oringing/ModbusRTU_Gateway/docs/协议说明.md

# Modbus RTU 协议实现说明

## 1. 协议实现范围

### 1.1 基本配置
- **工作模式**：Modbus RTU 从机
- **从机地址**：`MODBUS_SLAVE_ADDR = 0x01`
- **校验方式**：Modbus CRC-16（低字节在前，高字节在后）

### 1.2 已实现功能码
| 功能码 | 功能描述 | 状态 |
|---|---|---|
| `0x03` | 读保持寄存器 | ✅ 稳定实现 |
| `0x06` | 写单个寄存器 | ✅ 稳定实现 |

---

## 2. 帧处理流程

### 2.1 接收处理链路
```
UART_Driver_Receive() 
  → Modbus_ValidateFrame()  // 帧合法性校验
    → Modbus_Process()      // 功能码分发
      → 0x03/0x06 处理函数
```

### 2.2 帧校验规则（Modbus_ValidateFrame）
1. **最小帧长校验**：`frame_len ≥ MODBUS_MIN_FRAME_LEN (8 bytes)`（0x03/0x06 请求帧固定长度）
2. **从机地址校验**：`frame[MODBUS_RESP_ADDR_IDX] == MODBUS_SLAVE_ADDR`
3. **CRC-16 校验**：
   - **字节序**：低字节在前（`frame[len-2]`），高字节在后（`frame[len-1]`）
   - **校验范围**：除 CRC 外的所有字节（`frame[0] ~ frame[len-3]`）
   - **算法**：标准 Modbus CRC-16（多项式 `0xA001`，初始值 `0xFFFF`）

---

## 3. 功能码 `0x03` 实现规范

### 3.1 请求帧格式
| 字节偏移 | 字段 | 长度 | 宏定义 | 说明 |
|---|---|---|---|---|
| 0 | 从机地址 | 1 byte | `MODBUS_RESP_ADDR_IDX` | `0x01` |
| 1 | 功能码 | 1 byte | `MODBUS_RESP_FUNC_CODE_IDX` | `0x03` |
| 2-3 | 起始地址 | 2 bytes | `MODBUS_REQ_START_ADDR_HIGH_IDX` / `LOW_IDX` | 高字节在前（Big-Endian） |
| 4-5 | 寄存器数量 | 2 bytes | `MODBUS_REQ_REG_COUNT_HIGH_IDX` / `LOW_IDX` | 高字节在前 |
| 6-7 | CRC-16 | 2 bytes | - | **低字节在前，高字节在后** |

**示例帧**：`01 03 00 00 00 05 [CRC_L] [CRC_H]`
- 读取从地址 0 开始的 5 个寄存器

### 3.2 响应帧格式
| 字节偏移 | 字段 | 长度 | 宏定义 | 说明 |
|---|---|---|---|---|
| 0 | 从机地址 | 1 byte | `MODBUS_RESP_ADDR_IDX` | `0x01` |
| 1 | 功能码 | 1 byte | `MODBUS_RESP_FUNC_CODE_IDX` | `0x03` |
| 2 | 字节计数 | 1 byte | `MODBUS_RESP_BYTE_COUNT_IDX` | `寄存器数量 × 2` |
| 3~N | 寄存器数据 | N bytes | `MODBUS_RESP_DATA_START_IDX` + offset | 每个寄存器 2 bytes（高字节在前） |
| N+1~N+2 | CRC-16 | 2 bytes | - | **低字节在前，高字节在后** |

**示例响应**：`01 03 0A [Reg0_H] [Reg0_L] ... [Reg4_H] [Reg4_L] [CRC_L] [CRC_H]`

### 3.3 入参校验规则
| 校验项 | 规则 | 异常码 |
|---|---|---|
| 起始地址 | `start_addr < MODBUS_REG_MAX_COUNT` | `0x02`（非法数据地址） |
| 寄存器数量 | `reg_count ≥ 1 && reg_count ≤ MODBUS_MAX_READ_REGS (10)` | `0x03`（非法数据值） |
| 地址+数量边界 | `start_addr + reg_count ≤ MODBUS_REG_MAX_COUNT` | `0x02` |

---

## 4. 功能码 `0x06` 实现规范

### 4.1 请求帧格式
| 字节偏移 | 字段 | 长度 | 宏定义 | 说明 |
|---|---|---|---|---|
| 0 | 从机地址 | 1 byte | `MODBUS_RESP_ADDR_IDX` | `0x01` |
| 1 | 功能码 | 1 byte | `MODBUS_RESP_FUNC_CODE_IDX` | `0x06` |
| 2-3 | 寄存器地址 | 2 bytes | `MODBUS_REQ_REG_ADDR_HIGH_IDX` / `LOW_IDX` | 高字节在前 |
| 4-5 | 寄存器值 | 2 bytes | `MODBUS_REQ_REG_VALUE_HIGH_IDX` / `LOW_IDX` | 高字节在前 |
| 6-7 | CRC-16 | 2 bytes | - | **低字节在前，高字节在后** |

**示例帧**：`01 06 00 04 00 5A [CRC_L] [CRC_H]`
- 将地址 0x0004 的寄存器写入值 0x005A（十进制 90）

### 4.2 成功响应
- **响应内容**：原样回显请求帧（8 bytes）
- **响应时机**：寄存器值写入成功后立即回显

### 4.3 入参校验规则
| 校验项 | 规则 | 异常码 |
|---|---|---|
| 寄存器地址 | `addr < MODBUS_REG_MAX_COUNT` 且 `holding_regs[addr].read_only == false` | `0x02` / `0x03` |
| 写入值范围（仅舵机寄存器） | `0x0004: 0 ~ 180`（舵机角度）<br>`0x0005: 0 ~ 255`（舵机速度） | `0x03` |
| 其他寄存器 | 预留寄存器（0x0006-0x0009）无值范围限制，写入后原样回显 | - |

**说明**：
- 当前版本仅对舵机相关寄存器（0x0004/0x0005）实施严格的值范围校验
- 预留寄存器（0x0006-0x0009）允许写入任意合法16位值，但不影响系统功能
- 只读寄存器（0x0000-0x0003）禁止写入，返回异常码 0x03

---

## 5. 异常响应规范

### 5.1 异常帧格式
| 字节偏移 | 字段 | 长度 | 宏定义 | 说明 |
|---|---|---|---|---|
| 0 | 从机地址 | 1 byte | `MODBUS_EX_RESP_ADDR_IDX` | `0x01` |
| 1 | 异常功能码 | 1 byte | `MODBUS_EX_RESP_FUNC_CODE_IDX` | `原功能码 | 0x80` |
| 2 | 异常码 | 1 byte | `MODBUS_EX_RESP_EX_CODE_IDX` | 见下表 |
| 3-4 | CRC-16 | 2 bytes | - | **低字节在前，高字节在后** |

### 5.2 异常码定义
| 异常码 | 含义 | 触发条件 |
|---|---|---|
| `0x01` | 非法功能码 | 请求功能码非 0x03/0x06 |
| `0x02` | 非法数据地址 | 寄存器地址越界或不允许写入 |
| `0x03` | 非法数据值 | 寄存器数量非法或写入值超限 |

### 5.3 静默丢弃场景（不响应）
- CRC 校验失败
- 从机地址不匹配
- 帧长度不符合最小要求（< `MODBUS_MIN_FRAME_LEN`）

---

## 6. 寄存器映射表

**详细说明**：完整的寄存器地址表、默认值设计、死区保护机制请参见 [寄存器映射表.md](寄存器映射表.md)

### 6.1 寄存器访问策略
- **读操作（0x03）**：单次加锁快照读取，避免并发不一致
- **写操作（0x06）**：锁内更新值，锁外执行回调（避免死锁）
- **互斥保护**：所有寄存器访问通过 `s_modbus_reg_mutex` 互斥锁保护

## 7. AHT20与BMP280传感器数据更新机制

### 7.1 数据流转链路
```C
Device_Task (1000ms 周期) → EnvSensor_Driver_ReadData() // 读取 AHT20/BMP280 原始数据 → 数据转换（float → Modbus 寄存器格式） → Modbus_InternalWriteRegister() // 更新寄存器 0x0000-0x0002 → 状态寄存器更新（0x0003 Bit4-5）
```

### 7.2 数据转换规则
| 传感器数据 | 转换公式 | 寄存器地址 | 存储格式 |
|---|---|---|---|
| 温度（°C） | `reg = (int16_t)(temp × 10.0 + 0.5) + 1000` | 0x0000 | 有符号 16 位（偏移量 1000 支持零下温度），+0.5实现四舍五入 |
| 湿度（%RH） | `reg = (uint16_t)(humi × 10.0 + 0.5)` | 0x0001 | 无符号 16 位（保留 1 位小数） |
| 气压（hPa） | `reg = (uint16_t)(press × 10.0 + 0.5)` | 0x0002 | 无符号 16 位（保留 1 位小数） |

**示例**：
- 温度 25.6°C → `(25.6 × 10 + 0.5) + 1000 = 1256` → `0x04E8`
- 湿度 68.9% → `68.9 × 10 + 0.5 = 689` → `0x02B1`
- 气压 996.5 hPa → `996.5 × 10 + 0.5 = 9965` → `0x26ED`

### 7.3 故障处理策略
1. **重试机制**：单个传感器读取失败时重试 2 次（间隔 10ms）
2. **连续失败阈值**：连续失败 5 次后标记传感器故障（更新 0x0003 Bit4-5）
3. **总线恢复**：达到失败阈值后自动调用 `I2C_Bus_Recover()` 并重新初始化传感器
4. **数据保持**：读取失败时返回上次有效值，避免寄存器跳变
5. **温差校验**：AHT20 与 BMP280 温度差值超过 ±5°C 时丢弃 BMP280 数据

### 7.4 状态寄存器联动
- **Bit4（AHT20_READY）**：由 `EnvSensor_Driver_GetStatus()` 返回的 Bit4 同步更新
- **Bit5（BMP280_READY）**：由 `EnvSensor_Driver_GetStatus()` 返回的 Bit5 同步更新
- **更新时机**：每次传感器读取完成后立即更新，无论成功或失败
