oringing/ModbusRTU_Gateway/docs/寄存器映射表.md

# 寄存器映射表

>**最后更新**: 2026-05-20  
> 本文档提供 Modbus RTU 从机的完整寄存器映射、位定义及控制说明，适用于二次开发。  
> **宏定义位置**：[`App/Protocol/Inc/modbus.h`](../App/Protocol/Inc/modbus.h)  
> **协议层实现细节**：参见 [协议说明.md](协议说明.md)

## 📋 保持寄存器地址表（10 个）

**宏定义文件**：[`modbus.h:74-81`](../App/Protocol/Inc/modbus.h#L74-L81)

| 地址 | 宏定义 | 功能说明 | 读写 | 范围 | 联动功能 |
|---|---|---|---|---|---|
| 0x0000 | [MODBUS_REG_ADDR_SENSOR_TEMP](file://d:\STM32\myproject\ModbusRTU_Gateway\App\Protocol\Inc\modbus.h#L75-L76) | **AHT20 温度** | 只读 | 0x0258~0x073A（600~1850对应 -40.0~85.0°C） | 十进制实际值 = (存储值 - 1000) / 10 |
| 0x0001 | [MODBUS_REG_ADDR_SENSOR_HUMIDITY](file://d:\STM32\myproject\ModbusRTU_Gateway\App\Protocol\Inc\modbus.h#L76-L77) | **AHT20 湿度** | 只读 | 0x0000～0x03E8 （0~1000对应 0.0~100.0%RH） | 十进制实际值 = 存储值 / 10 |
| 0x0002 | [MODBUS_REG_ADDR_SENSOR_PRESSURE](file://d:\STM32\myproject\ModbusRTU_Gateway\App\Protocol\Inc\modbus.h#L77-L78) | **BMP280 气压** | 只读 | 0x0BB8~0x2AF8（3000~11000对应 300.0~1100.0 hPa） | 十进制实际值 = 存储值 / 10 |
| 0x0003 | [MODBUS_REG_ADDR_DEVICE_STATUS](file://d:\STM32\myproject\ModbusRTU_Gateway\App\Protocol\Inc\modbus.h#L78-L79) | **系统状态寄存器** | 只读 | 位定义见下 | 心跳+故障标志 |
| 0x0004 | [MODBUS_REG_ADDR_SERVO_TARGET](file://d:\STM32\myproject\ModbusRTU_Gateway\App\Protocol\Inc\modbus.h#L79-L80) | **180° 舵机目标角度** | 读写 | 0~180 | TIM3_CH1/PA6 |
| 0x0005 | [MODBUS_REG_ADDR_SERVO_SPEED](file://d:\STM32\myproject\ModbusRTU_Gateway\App\Protocol\Inc\modbus.h#L80-L81) | **360° 舵机速度/方向** | 读写 | 0~255 | TIM3_CH2/PA7 |
| 0x0006~0x0009 | - | 预留扩展 | 读写 | 0x0000 | 未来功能扩展 |
---

## ⚙️ 寄存器默认初始值

**代码位置**：[`modbus.c:25-26`](../App/Protocol/Src/modbus.c#L25-L26)

``` c
//（舵机寄存器默认值超出合法范围, 强制主机首次写入合法角度后舵机才能使用）

static const uint16_t s_default_regs[] = {
    0x0000U,  // 对应地址 0x0000: AHT20 温度（预留）
    0x1000U,  // 对应地址 0x0001: AHT20 湿度（预留）
    0x2000U,  // 对应地址 0x0002: BMP280 气压（预留）
    0x3000U,  // 对应地址 0x0003: 系统状态寄存器（心跳+标志位）
    0x4000U,   // 对应地址 0x0004: 180° 舵机目标角度
    0x5000U   // 对应地址 0x0005: 360° 舵机速度/方向
};
//剩余地址0x0007-0x0009寄存器值默认为0x0000
```

### 默认值设计说明

| 寄存器地址 | 默认值（十六进制） | 默认值（十进制） | 设计意图 |
|---|---|---|---|
| 0x0000 | `0x0000` | 0 | 传感器未初始化时返回零值，便于主机判断设备状态 |
| 0x0001 | `0x1000` | 4096 | 占位符，区分于温度寄存器（0x0000），避免误判 |
| 0x0002 | `0x2000` | 8192 | 占位符，区分于温湿度寄存器，便于调试识别 |
| 0x0003 | `0x3000` | 12288 | Bit 8-15 = 0x30（系统标识），Bit 0-7 = 0x00（初始心跳位） |
| 0x0004 | `0x4000` | 16384 | **故意设置为非法值**，强制主机首次写入合法角度（0-180）后才可使用舵机 |
| 0x0005 | `0x5000` | 0 | 360° 舵机默认反转最快，需主机显式写入中位（0x7F）停止 |

**⚠️ 重要提示**：
- **不要随意修改默认值**：这些值经过精心设计，用于区分不同寄存器类型和强制主机初始化
- **地址 0x0004 的非法默认值**：确保舵机在上电后不会意外转动，必须由主机显式写入合法角度
- **传感器占位符**：0x0000~0x2000 为初始化占位符，Device_Task 启动后会被真实传感器数据覆盖

---

## 🔍 寄存器详细说明

### 0x0000~0x0002 - 传感器数据（已接入）

**读写权限**：只读（R）  
**当前状态**：**已由 Device_Task 每 1 秒自动更新真实传感器数据**  
**数据来源**：AHT20（温湿度）+ BMP280（气压/温度）  
**更新机制**：详见 [协议说明.md - 传感器数据更新机制](协议说明.md#7-传感器数据更新机制)

| 地址 | 传感器类型 | 数据格式 | 说明 |
|---|---|---|---|
| 0x0000 | AHT20 温度 | 有符号 16 位（×10 + 1000偏移） | 单位 0.1℃，存储值 = (温度 × 10) + 1000（添加偏移量支持零下温度），范围 -400~1850 |
| 0x0001 | AHT20 湿度 | 无符号 16 位（×10） | 单位 0.1% RH，范围 0~1000 |
| 0x0002 | BMP280 气压 | 无符号 16 位（×10） | 单位 0.1 hPa，范围 3000~11000 |

**读取示例**（假设温度 25.6℃，湿度 68.9%，气压 996.5 hPa）：

| 寄存器 | 实际值 | 计算公式 | 存储值 | 十六进制 |
|---|---|---|---|---|
| 0x0000 | 25.6℃ | (25.6 × 10) + 1000 = 1256 | 1256 | 0x04E8 |
| 0x0001 | 68.9% | 68.9 × 10 = 689 | 689 | 0x02B1 |
| 0x0002 | 996.5 hPa | 996.5 × 10 = 9965 | 9965 | 0x26ED |

发送指令：`01 03 00 00 00 03 05 CB`
预期响应：`01 03 06 04 E8 02 B1 26 ED XX XX`

**故障场景**：
- 传感器未接入或初始化失败：默认值不变（0x0000/0x1000/0x2000）
- 传感器初始化后突发故障：返回上次有效值（保持寄存器不变）
- 状态寄存器 Bit4/Bit5 可用于判断传感器健康状态

### 0x0003 - 系统状态寄存器

**读写权限**：只读（R）  
**初始值**：`0x3000`（上电复位后）  
**更新频率**：每秒自动更新（心跳 Bit 0~3）

#### 位定义

| Bit 位 | 名称 | 含义 | 默认值 | 说明 |
|---|---|---|---|---|
| 0~3 | `HEARTBEAT_COUNTER` | 心跳计数器 | 动态翻转 | 0x0000 ↔ 0x000F，每秒翻转一次 |
| 4 | `AHT20_READY` | AHT20 传感器状态 | 0 | 0=故障/未接入，1=正常 |
| 5 | `BMP280_READY` | BMP280 传感器状态 | 0 | 0=故障/未接入，1=正常 |
| 6 | `SERVO_DRIVER_READY` | 舵机驱动就绪标志 | 1 | 0=故障/未接入，1=正常 |
| 7 | `UART_COMM_NORMAL` | UART 通信正常标志 | 1 | 0=故障/未接入，1=正常 |
| 8-11 | 预留 |  |  |  |
| 12~15 | `RESERVED` | 保留 | 0x30 | 固定为 0x30（系统标识） |

#### 心跳运行机制（假设AHT20与BMP280传感器正常）

- **初始值**: `0x3000`（Bit 4-7 = 0x3，Bit 0-3 = 0x0）
- **翻转逻辑**: 每秒执行 `current_val ^ 0x000F`
  - 第 0 秒：`0x3030`（心跳位 0x0000）
  - 第 1 秒：`0x303F`（心跳位 0x000F）
  - 第 2 秒：`0x3030`（心跳位恢复 0x0000）
  - 循环往复：`0x3030 ↔ 0x300F`

#### 读取示例

**发送指令**：`01 03 00 03 00 01 74 0A`

**预期响应**：`01 03 02 30 30 AC 44` 或 `01 03 02 30 3F EC 40`

**验证方法**：
连续读取该寄存器，观察高字节的变化：
```
首次读取: 01 03 02 30 30 AC 44  （0x3000）
1s后: 01 03 02 30 3F EC 40  （0x300F）
2s后: 01 03 02 30 30 AC 44  （0x3000）
...
```

---

### 0x0004 - 180° 舵机目标角度

**读写权限**：可写（W）  
**控制方式**：Modbus 写单寄存器（0x06）

#### 参数映射

| 写入值（十六进制） | 对应角度 | PWM 脉宽 | 占空比 |
|---|---|---|---|
| 0x00 | 0° | 0.5ms |  2.5% |
| 0x5A |  90° | 1.5ms |  7.5% |
| 0xB4 | 180° | 2.5ms | 12.5% |

#### 计算公式

```c
// 角度 → PWM 脉宽（微秒）
pulse_width_us = 500 + (angle * 2000 / 180);

// PWM 脉宽 → 占空比（50Hz，周期 20ms）
duty_cycle = pulse_width_us / 20000.0;
```

#### 写入示例

**发送指令**：`01 06 00 04 00 5A 48 30`（写入 90°）

**预期响应**：`01 06 00 04 00 5A 48 30`（原样回显）

**验证方法**：
1. 发送写入指令
2. 观察舵机是否转到 90°
3. 发送读取指令 `01 03 00 04 00 01 C5 CB` 确认返回值

**读取确认响应**：`01 03 02 00 5A 38 7F`

#### 错误处理

| 错误场景 | 返回异常帧 | 异常码 |
|---|---|---|
| 写入值 > 0xB4 | `01 86 03 02 61 ` | 0x03（非法数据值） |
| 写入值 < 0x00 | `01 86 03 02 61 ` | 0x03（非法数据值） |

---

### 0x0005 - 360° 舵机速度/方向

**读写权限**：可写（W）  
**控制方式**：Modbus 写单寄存器（0x06）

#### 参数映射

| 写入值 | 运动状态 | PWM 脉宽 | 占空比 | 说明 |
|---|---|---|---|---|
| 0x00~0x74 | 反转调速 | 2.5~1.60ms | 12.5~8.0% | 值越小反转越快 |
| **0x75** | **慢速反转** | **1.58ms** | **7.9%** | **反转有效下界（稳定转动）** |
| **0x76~0x88** | **死区保护** | **1.5ms** | **7.5%** | **固件强制归零至0x7F，舵机静止** |
| **0x89** | **慢速正转** | **1.42ms** | **7.1%** | **正转有效上界（稳定转动）** |
| 0x8A~0xFF | 正转调速 | 1.40~0.5ms | 7.0~2.5% | 值越大正转越快 |

**⚠️ 死区保护机制**：
- **自动过滤范围**：0x76-0x88（十进制118-136，共19个值）
- **保护策略**：写入此范围内的任意值，固件内部自动转换为0x7F（完全停止）
- **设计目的**：避免PWM脉宽变化过小（<80μs）导致舵机在"微动"与"静止"间随机切换，应对长时间运转后的机械磨损和温度漂移
- **有效速度边界**：
  - 反转有效范围：0x00-0x75（0x75为慢速反转边界，稳定转动）  
  - 正转有效范围：0x89-0xFF（0x89为慢速正转边界，稳定转动）

**✅ 固件已实现自动死区保护**：
- **死区范围**：0x76-0x88（±10档，对应PWM变化约±80μs）
- **保护策略**：写入此范围内的任意值，固件自动强制归零至0x7F（完全停止）
- **有效速度边界**：
  - 反转有效范围：0x00-0x75（0x75对应慢速反转，0x00对应最大速度反转）  
  - 正转有效范围：0x88-0xFF（0x88对应慢速正转，0xFF对应最大速度正转）   

**建议**：
1. **跳变策略**：如需反转→正转切换，建议直接跳变至目标速度（如0x60→0xA0），避免逐步穿越死区
2. **最小有效速度**：实际应用中建议设置最小有效速度为 0x50（反转）和 0xA0（正转），预留更大安全裕度
3. **应用层滤波**：如需更平滑控制，可在上位机实现滞回比较器或斜坡函数

#### 写入示例

**正转**：
- 发送指令：`01 06 00 05 00 FF D9 8B`（写入 255）
- 预期响应：`01 06 00 05 00 FF D9 8B`
- 观察现象：舵机正转最快

**停止**：
- 发送指令：`01 06 00 05 00 7F D8 2B`（写入 127）
- 预期响应：`01 06 00 05 00 7F D8 2B`
- 观察现象：舵机完全静止

**反转**：
- 发送指令：`01 06 00 05 00 00 99 CB`（写入 0）
- 预期响应：`01 06 00 05 00 00 99 CB`
- 观察现象：舵机反转最快

#### 错误处理

| 错误场景 | 返回异常帧 | 异常码 |
|---|---|---|
| 写入值 > 0xFF  | `01 86 03 02 61 ` | 0x03（非法数据值） |
| 写入值 < 0x00 | `01 86 03 02 61 ` | 0x03（非法数据值） |

---

## 🛠️ 常用 Modbus 指令速查

### 读保持寄存器（0x03）

**格式**：`[从机地址] [功能码] [起始地址高] [起始地址低] [数量高] [数量低] [CRC 低] [CRC 高]`

**示例**：
```
# 读地址 0x0004（180° 舵机当前角度）
01 03 00 04 00 01 C5 CB

# 读地址 0x0000~0x0002（传感器数据）
01 03 00 00 00 03 05 CB

# 读地址 0x0003（系统状态）
01 03 00 03 00 01 74 0A
```

### 写单寄存器（0x06）

**格式**：`[从机地址] [功能码] [地址高] [地址低] [值高] [值低] [CRC 低] [CRC 高]`

**示例**：
```
# 写地址 0x0004，值 90（舵机转到 90°）
01 06 00 04 00 5A 48 30

# 写地址 0x0005，值 255（360° 舵机正转最快）
01 06 00 05 00 FF D9 8B
```

### 异常响应

**格式**：`[从机地址] [功能码+0x80] [异常码] [CRC 低] [CRC 高]`

**异常码定义**：
- `0x01`：非法功能码
- `0x02`：非法数据地址
- `0x03`：非法数据值

**示例**：
```
# 越界地址访问（地址 0x0010 超出范围）
请求: 01 06 00 10 00 01 49 CF
响应: 01 86 02 C3 A1  （异常码 0x02）

# 非法值写入（值 500 超出 0~180 范围）
请求: 01 06 00 04 01 F4 C8 1C 
响应: 01 86 03 02 61   （异常码 0x03）
```

---

## 📊 寄存器访问时序图

### 正常读写流程

```
主机                          从机
 │                              │
 │发─── 01 06 00 04 00 5A ─────►│  （写 90°）
 │                              │
 │收◄─── 01 06 00 04 00 5A ─────│  （原样回显）
 │                              │
 │发─── 01 03 00 04 00 01 ─────►│  （读确认）
 │                              │
 │收◄─── 01 03 02 00 5A ────────│  （返回 90）
 │                              │
```

### 异常处理流程
- 以0x02非法数据地址为例

```
主机                          从机
 │                              │
 │发─── 01 06 00 10 00 01 ──────►│  （写越界地址）
 │                              │
 │收◄─── 01 86 02 ───────────────│  （异常码 0x02）
 │                              │
```

---

## ⚠️ 注意事项

### 1. CRC 校验
- **字节序**：低字节在前，高字节在后
- **算法**：CRC-16/MODBUS（多项式 0x8005）
- **工具推荐**：串口助手内置 ModbusCRC16 自动计算功能（务必勾选）

### 2. 响应超时
- **典型延迟**：< 1ms
- **超时阈值**：建议设置 100ms（包含网络抖动余量）

### 3. 并发访问
- 寄存器访问已加互斥锁保护
- 单次加锁快照读取，避免并发一致性风险
- 写回调锁外执行，避免阻塞主流程

### 4. 断电保存
- 当前版本不支持寄存器值断电保存
- 重启后所有可写寄存器恢复默认值

### 5. 传感器数据特性
- **更新周期**：1000 ms（由 Device_Task 控制）
- **数据精度**：温度 ±0.3°C，湿度 ±2%RH，气压 ±1 hPa
- **故障恢复**：连续失败 5 次后自动触发 I2C 总线恢复
- **温差保护**：AHT20 与 BMP280 温度差超过 ±5°C 时丢弃 BMP280 数据
- **状态监控**：通过寄存器 0x0003 的 Bit4-5 实时监控传感器健康状态

---

**返回 [README.md](../Readme.md)** | **[硬件接线指南](HARDWARE.md)** | **[测试指南](TESTING.md)**
