oringing/ModbusRTU_Gateway/MotorGateway.ioc

Mcu.UserName=STM32F103C8Tx
PA10.Signal=USART1_RX
PA9.Signal=USART1_TX
PC13-TAMPER-RTC.GPIO_Label=LED_C13
PC13-TAMPER-RTC.Signal=GPIO_Output
PD0-OSC_IN.Signal=RCC_OSC_IN
PD1-OSC_OUT.Signal=RCC_OSC_OUT
