oringing/ModbusRTU_Gateway/Bsp/Src/soft_i2c.c

// Bsp/Src/soft_i2c.c
#include "cmsis_os.h"  // 添加这个头文件
#include "soft_i2c.h"
#include "stm32f1xx_hal.h"

// 软件 I2C 位延时（约 5μs）
static void Soft_I2C_Delay(void) {
    for (volatile uint32_t i = 0; i < 8; i++) {
        __NOP();
    }
}

void delay_ms(uint32_t ms) {
    // 如果调度器已运行，使用 RTOS 延时（让出 CPU）
    if (xTaskGetSchedulerState() == taskSCHEDULER_RUNNING) {
        vTaskDelay(pdMS_TO_TICKS(ms));
    } else {
        // 调度器未启动，使用空循环
        volatile uint32_t count = ms * 12000;  // 72MHz 校准值
        while (count--) {
            __NOP();
        }
    }
}

// 全局重试间隔，默认 55ms，0 表示不重试,BSP 初始化或任务上下文可修改，ISR 中请勿修改
static unsigned short RETRY_IN_MLSEC = I2C_DEFAULT_RETRY_MS;

void Set_I2C_Retry(unsigned short ml_sec) {
    RETRY_IN_MLSEC = ml_sec;
}

unsigned short Get_I2C_Retry(void) {
    return RETRY_IN_MLSEC;
}

// 将 SDA/SCL 配置为开漏输出，总线空闲时外部 4.7kΩ 电阻上拉至高电平
void I2C_Bus_Init(void) {
    GPIO_InitTypeDef GPIO_InitStruct = {0};

    __HAL_RCC_GPIOB_CLK_ENABLE();

    GPIO_InitStruct.Pin = SOFT_I2C_SCL | SOFT_I2C_SDA;
    GPIO_InitStruct.Mode = GPIO_MODE_OUTPUT_OD;
    GPIO_InitStruct.Pull = GPIO_PULLUP;
    GPIO_InitStruct.Speed = GPIO_SPEED_FREQ_HIGH;
    HAL_GPIO_Init(SOFT_I2C_PORT, &GPIO_InitStruct);

    SOFT_I2C_SCL_1;
    SOFT_I2C_SDA_1;
    Soft_I2C_Delay();
}

// 起始条件：SCL 高电平期间 SDA 由高变低，同时检测总线忙
static uint8_t Soft_I2C_Start(void) {
    SOFT_I2C_SDA_1;
    Soft_I2C_Delay();

    SOFT_I2C_SCL_1;
    Soft_I2C_Delay();

    // 检查总线是否被其他设备占用（SDA 应为高电平）
    if (!SOFT_I2C_SDA_READ) {
        return 1; // 总线忙
    }

    SOFT_I2C_SDA_0;
    Soft_I2C_Delay();

    SOFT_I2C_SCL_0;
    Soft_I2C_Delay();

    return 0;
}

// 停止条件：SCL 高电平期间 SDA 由低变高
static void Soft_I2C_Stop(void) {
    SOFT_I2C_SDA_0;
    Soft_I2C_Delay();

    SOFT_I2C_SCL_1;
    Soft_I2C_Delay();

    SOFT_I2C_SDA_1;
    Soft_I2C_Delay();
}

// 主机发送 ACK（拉低 SDA），在多字节读取中确认继续读取下一个字节
static void Soft_I2C_SendAck(void) {
    SOFT_I2C_SDA_0;
    Soft_I2C_Delay();
    SOFT_I2C_SCL_1;
    Soft_I2C_Delay();
    SOFT_I2C_SCL_0;
    Soft_I2C_Delay();
}

// 主机发送 NACK（释放 SDA）
static void Soft_I2C_SendNack(void) {
    SOFT_I2C_SDA_1;
    Soft_I2C_Delay();
    SOFT_I2C_SCL_1;
    Soft_I2C_Delay();
    SOFT_I2C_SCL_0;
    Soft_I2C_Delay();
}

// 等待从机应答：第 9 个时钟周期检查 SDA 是否被拉低
static uint8_t Soft_I2C_WaitAck(void) {
    uint32_t start_tick = HAL_GetTick();

    SOFT_I2C_SDA_1;
    Soft_I2C_Delay();
    SOFT_I2C_SCL_1;
    Soft_I2C_Delay();

    while (SOFT_I2C_SDA_READ) {
        // 超时保护（基于系统 tick）
        if ((HAL_GetTick() - start_tick) >= I2C_WAIT_ACK_TIMEOUT_MS) {
            Soft_I2C_Stop();
            return 2; // 无应答超时
        }
    }

    SOFT_I2C_SCL_0;
    Soft_I2C_Delay();
    return 0;
}

// 发送一个字节（MSB 优先），返回从机应答状态
static uint8_t Soft_I2C_SendByte(uint8_t data) {
    uint8_t i;

    SOFT_I2C_SCL_0;
    for (i = 0; i < 8; i++) {
        if (data & 0x80) {
            SOFT_I2C_SDA_1;
        } else {
            SOFT_I2C_SDA_0;
        }
        data <<= 1;
        Soft_I2C_Delay();

        SOFT_I2C_SCL_1;
        Soft_I2C_Delay();
        SOFT_I2C_SCL_0;
        Soft_I2C_Delay();
    }
    return Soft_I2C_WaitAck();
}

// 接收一个字节，最后发送 NACK（用于读取最后一个字节）
static uint8_t Soft_I2C_ReceiveByte(void) {
    uint8_t i, data = 0;

    SOFT_I2C_SDA_1;
    SOFT_I2C_SCL_0;

    for (i = 0; i < 8; i++) {
        SOFT_I2C_SCL_1;
        Soft_I2C_Delay();
        data <<= 1;
        if (SOFT_I2C_SDA_READ) {
            data |= 0x01;
        }
        SOFT_I2C_SCL_0;
        Soft_I2C_Delay();
    }
    Soft_I2C_SendNack();
    return data;
}

// 接收一个字节并发送 ACK（用于读取非最后一个字节）
static uint8_t Soft_I2C_ReceiveByteWithAck(void) {
    uint8_t i, data = 0;

    SOFT_I2C_SDA_1;
    SOFT_I2C_SCL_0;

    for (i = 0; i < 8; i++) {
        SOFT_I2C_SCL_1;
        Soft_I2C_Delay();
        data <<= 1;
        if (SOFT_I2C_SDA_READ) {
            data |= 0x01;
        }
        SOFT_I2C_SCL_0;
        Soft_I2C_Delay();
    }
    Soft_I2C_SendAck();
    return data;
}

// ========== 寄存器式传感器接口 ==========

// 写寄存器：START + 写地址 + 寄存器地址 + 数据 + STOP
static uint8_t Soft_I2C_WriteReg(uint8_t dev_addr, uint8_t reg_addr, uint16_t len,
                                 const uint8_t* data) {
    uint8_t i, result;

    result = Soft_I2C_Start();
    if (result) {
        return result;
    }

    result = Soft_I2C_SendByte((dev_addr << 1) | 0);
    if (result) {
        Soft_I2C_Stop();
        return result;
    }

    result = Soft_I2C_SendByte(reg_addr);
    if (result) {
        Soft_I2C_Stop();
        return result;
    }

    for (i = 0; i < len; i++) {
        result = Soft_I2C_SendByte(data[i]);
        if (result) {
            Soft_I2C_Stop();
            return result;
        }
    }

    Soft_I2C_Stop();
    return 0;
}

// 读寄存器：START + 写地址 + 寄存器地址 + RESTART + 读地址 + 数据 + STOP
static uint8_t Soft_I2C_ReadReg(uint8_t dev_addr, uint8_t reg_addr, uint16_t len, uint8_t* data) {
    uint8_t result;

    result = Soft_I2C_Start();
    if (result) {
        return result;
    }

    result = Soft_I2C_SendByte((dev_addr << 1) | 0);
    if (result) {
        Soft_I2C_Stop();
        return result;
    }

    result = Soft_I2C_SendByte(reg_addr);
    if (result) {
        Soft_I2C_Stop();
        return result;
    }

    result = Soft_I2C_Start();
    if (result) {
        Soft_I2C_Stop();
        return result;
    }

    result = Soft_I2C_SendByte((dev_addr << 1) | 1);
    if (result) {
        Soft_I2C_Stop();
        return result;
    }

    while (len) {
        if (len == 1) {
            *data = Soft_I2C_ReceiveByte();
        } else {
            *data = Soft_I2C_ReceiveByteWithAck();
        }
        data++;
        len--;
    }

    Soft_I2C_Stop();
    return 0;
}

bool Sensors_I2C_WriteRegister(unsigned char slave_addr, unsigned char reg_addr, unsigned short len,
                               const unsigned char* data_ptr) {
    bool ret;
    unsigned short retry = Get_I2C_Retry();

    do {
        ret = (Soft_I2C_WriteReg(slave_addr, reg_addr, len, data_ptr) == 0);
        if (ret) {
            break;
        }
        if (retry) delay_ms(retry);
    } while (retry--);

    return ret;
}


bool Sensors_I2C_ReadRegister(unsigned char slave_addr, unsigned char reg_addr, unsigned short len,
                              unsigned char* data_ptr) {
    bool ret;
    unsigned short retry = Get_I2C_Retry();

    do {
        ret = (Soft_I2C_ReadReg(slave_addr, reg_addr, len, data_ptr) == 0);
        if (ret) {
            break;
        }
        if (retry) delay_ms(retry);
    } while (retry--);

    return ret;
}

// ========== 命令式传感器接口 ==========

// 只写命令：START + 写地址 + 命令字节 + STOP（无寄存器地址）
static uint8_t Soft_I2C_WriteCmd(uint8_t dev_addr, uint16_t len, const uint8_t* data) {
    uint8_t i, result;

    result = Soft_I2C_Start();
    if (result) {
        return result;
    }

    result = Soft_I2C_SendByte((dev_addr << 1) | 0);
    if (result) {
        Soft_I2C_Stop();
        return result;
    }

    for (i = 0; i < len; i++) {
        result = Soft_I2C_SendByte(data[i]);
        if (result) {
            Soft_I2C_Stop();
            return result;
        }
    }

    Soft_I2C_Stop();
    return 0;
}

// 写命令字节到指定从机地址
static uint8_t Soft_I2C_WriteAddrAndCmd(uint8_t dev_addr, uint8_t cmd) {
    uint8_t result;

    result = Soft_I2C_Start();
    if (result) {
        return result;
    }

    result = Soft_I2C_SendByte((dev_addr << 1) | 0);
    if (result) {
        Soft_I2C_Stop();
        return result;
    }

    result = Soft_I2C_SendByte(cmd);
    if (result) {
        Soft_I2C_Stop();
        return result;
    }

    return 0;
}

// 重启总线并读取数据：RESTART + 读地址 + 数据 + STOP
static uint8_t Soft_I2C_RestartAndRead(uint8_t dev_addr, uint16_t len, uint8_t* data) {
    uint8_t result;

    result = Soft_I2C_Start();
    if (result) {
        Soft_I2C_Stop();
        return result;
    }

    result = Soft_I2C_SendByte((dev_addr << 1) | 1);
    if (result) {
        Soft_I2C_Stop();
        return result;
    }

    while (len) {
        if (len == 1) {
            *data = Soft_I2C_ReceiveByte();
        } else {
            *data = Soft_I2C_ReceiveByteWithAck();
        }
        data++;
        len--;
    }

    Soft_I2C_Stop();
    return 0;
}

// 组合操作：写命令后立即重启读取数据（AHT20 专用流程）
static uint8_t Soft_I2C_ReadCmdData(uint8_t dev_addr, uint8_t cmd, uint16_t len, uint8_t* data) {
    uint8_t result;

    result = Soft_I2C_WriteAddrAndCmd(dev_addr, cmd);
    if (result) {
        return result;
    }

    result = Soft_I2C_RestartAndRead(dev_addr, len, data);
    return result;
}

bool Sensors_I2C_WriteCommand(unsigned char slave_addr, const unsigned char* data,
                              unsigned short len) {
    bool ret;
    unsigned short retry = Get_I2C_Retry();

    if (data == NULL || len == 0) {
        return false;
    }

    do {
        ret = (Soft_I2C_WriteCmd(slave_addr, len, data) == 0);
        if (ret) {
            break;
        }
        if (retry) delay_ms(retry);
    } while (retry--);

    return ret;
}

bool Sensors_I2C_ReadCommandData(unsigned char slave_addr, unsigned char cmd, unsigned char* data,
                                 unsigned short len) {
    bool ret;
    unsigned short retry = Get_I2C_Retry();

    do {
        ret = (Soft_I2C_ReadCmdData(slave_addr, cmd, len, data) == 0);
        if (ret) {
            break;
        }
        if (retry) delay_ms(retry);
    } while (retry--);

    return ret;
}

// I2C 总线恢复：发送 9 个时钟脉冲 + 停止条件 + 重新初始化 GPIO
void I2C_Bus_Recover(void) {
    uint8_t i;
    
    // 1. 配置 SCL 和 SDA 为推挽输出（强制控制总线）
    GPIO_InitTypeDef GPIO_InitStruct = {0};
    
    GPIO_InitStruct.Pin = SOFT_I2C_SCL | SOFT_I2C_SDA;
    GPIO_InitStruct.Mode = GPIO_MODE_OUTPUT_PP;  // 推挽输出
    GPIO_InitStruct.Pull = GPIO_NOPULL;
    GPIO_InitStruct.Speed = GPIO_SPEED_FREQ_HIGH;
    HAL_GPIO_Init(SOFT_I2C_PORT, &GPIO_InitStruct);
    
    // 2. 发送 9 个时钟脉冲，尝试释放从机
    SOFT_I2C_SDA_1;  // 释放 SDA
    for (i = 0; i < 9; i++) {
        SOFT_I2C_SCL_0;
        Soft_I2C_Delay();
        SOFT_I2C_SCL_1;
        Soft_I2C_Delay();
    }
    
    // 3. 发送停止条件
    Soft_I2C_Stop();
    
    // 4. 重新初始化为开漏输出
    I2C_Bus_Init();
    
    // 5. 等待总线稳定
    delay_ms(10);
}
