oringing/ModbusRTU_Gateway/(commit log)

2026-04-14 feat: 完成阶段一基础框架搭建，实现LED闪烁和UART通信 - 配置了FreeRTOS任务调度 - 实现了LED 500ms闪烁功能 - 实现了UART 115200bps通信 - 添加了Readme.md项目说明
2026-04-23 feat: 实现modbus - 重构项目结构，将代码按功能划分为Bsp（硬件抽象层）、App（应用逻辑层）和Core（核心启动与FreeRTOS）三层 - 成功实现Modbus RTU从机协议栈，支持`0x03`读保持寄存器，包含地址过滤、CRC16校验及基于空闲中断的帧接收机制 - 验证：通过逻辑分析仪与ttl调试器，验证了Modbus RTU通信的稳定性和数据准确性。
2026-04-25 refactor(core): 深度解耦main.c并完成App层精细化分层
    - 架构重构：按规范将App层精细划分为Driver、Protocol、System、Task四个子模块，彻底解决业务代码散乱问题
    - main.c解耦：剥离全局UART句柄至Bsp层私有化，移除裸露的任务创建代码；main.c现仅保留硬件初始化与System_StartTasks()启动总控
    - 系统调度收拢：将任务栈大小、优先级等配置统一至system_config.h；任务创建与句柄管理收敛于system_ctrl.c，消除高风险的extern全局句柄
    - 完善错误机制：新建error_handler模块，统一处理系统Safe Mode、栈溢出Hook及HardFault等中断的分级告警
    - 驱动隔离(BSP自治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
    [driver_uart.c, driver_uart.h, error_handler.c, error_handler.h, main.c, modbus.c, modbus.h]
2026-04-25 fix: 强化系统启动与UART恢复链路，提升任务管理健壮性
    - system_ctrl.c/.h：新增启动配置校验（fail-fast），统一任务启停流程，创建失败立即回滚
    - led_task/uart_task/monitor_task：增加 RequestStop 退出机制，替换直接强杀为“请求退出+超时兜底”
    - uart.c：完善 HAL_UART_Receive_IT 多路径返回值检查；新增 UART 错误分级与恢复（区分 HAL_BUSY 与硬错误），加入重试/日志限频
    - uart.c：优化 BSP_UART_ReadFrame 临界区，移除关中断区内 memcpy，缩短不可抢占窗口
    - system_config.h：按栈水位重设任务栈（LED/UART/MONITOR）并补充停止超时配置
    - uart.h/modbus.h：统一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
    [key.h, led.c, led.h, main.c]
2026-04-29 fix: stabilize modbus slave receive path and task control
    [driver_uart.c, error_handler.c, error_handler.h, modbus.c, modbus.h, monitor_task.c, system_config.h, system_ctrl.c]
2026-04-29 refactor:：将 Modbus 0x03 功能流程拆分为帧校验与业务处理两个独立步骤
2026-04-29 refactor：移除错误处理测试残留代码，统一日志发送路径
2026-04-29 improve：屏蔽重复栈水位告警
2026-04-30 chore: 清理已跟踪的 Keil 构建产物并补充生成文件忽略规则
2026-04-30 fix: 为 Modbus 寄存器访问补互斥保护并避免锁内回调
    [modbus.c]
2026-04-30 fix: 保持 0x03 多寄存器响应在单次加锁快照内构
    [modbus.c, uart.c]
2026-04-30 fix: 隔离 Modbus UART 日志，避免系统日志信息与Modbus字节流相互污染
    [error_handler.c, system_config.h, system_ctrl.c, uart.c]
2026-04-30 fix: 统一 UART 接收恢复路径并收口 RX 重启策略
    [system_config.h, uart.c]
2026-04-30 fix: 减少 UART 任务固定轮询延迟以缩小背靠背请求窗口
    [uart_task.c]
2026-05-02 fix: 前移 UART 封帧与重挂接收，缩小背靠背请求窗口
    [system_config.h, uart.c]
2026-05-05 feat(modbus): 实现0x06写单寄存器功能码最小闭环 - 完成Modbus RTU功能码0x06的核心处理逻辑 - 支持合法写操作、越界地址、只读寄存器、非法值等场景 - 返回标准异常响应帧，CRC错误帧无响应 - 冻结寄存器映射与写入规则，为外设接入做准备
2026-05-05 WIP: 0x06功能开发中，暂存进度
2026-05-06 feat: 为关键接口添加参数有效性校验并修复链接问题 - 在UART驱动接口中添加空指针和长度校验 - 为Modbus寄存器访问函数添加地址边界检查 - 为系统控制接口添加参数有效性验证 - 防止因非法参数导致的数组越界和程序崩溃 - 暂时解决链接错误：将SYSTEM_USE_IWDG设置为不开启，因为工程中未包含stm32f1xx_hal_iwdg.c文件
    [modbus.c, monitor_task.c, system_config.h, system_ctrl.c, system_ctrl.h, uart.c]
2026-05-07 Delete MDK-ARM/RTE directory
    chore: remove Keil generated files
2026-05-07 Delete MDK-ARM/ModbusRTU_Gateway.uvguix.oranging
    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
2026-05-07 Delete MDK-ARM/ModbusRTU_Gateway.uvoptx
    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
2026-05-07 Delete MDK-ARM/startup_stm32f103xb.lst
    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
2026-05-07 feat: 核心对外接口入参有效性校验修复与测试 - 为 Modbus 寄存器访问接口添加空指针、地址越界、长度超限校验 - 实现 7 个单元测试用例，覆盖异常场景验证 - 集成 IWDG 看门狗驱动代码（未模拟故障测试） - 清理临时测试代码，归档测试文件至 App/Test/ - 更新 .gitignore 规则，同步远程仓库忽略策略
    [main.c, modbus.c, monitor_task.c, system_config.h, system_ctrl.c, uart.c]
2026-05-08 fix(iwdg): 完成看门狗功能集成与故障模拟验证 - 修正重载值 4095→312，超时从26秒改为预设的2秒 - 强制开启 LSI 时钟确保看门狗时钟源就绪 - 通过故意阻塞喂狗任务，验证系统在 2 秒内自动复位 - 恢复 Monitor_Task 正常喂狗逻辑，清理测试死循环代码 - 使用逻辑分析仪验证复位信号时序正确
    [monitor_task.c, system_config.h]
2026-05-08 fix: 增加 UART 错误恢复熔断机制，测试未达预期
    - 新增重试计数器与故障标记，超过 10 次失败停止恢复
    - 增加连续 5 帧正常接收后的故障自愈逻辑
    - 防止错误恢复死循环，避免任务阻塞
    - 测试未通过：当前无法模拟出硬件错误触发熔断逻辑
    - 后续需重新设计硬件错误测试方案
    [uart.c, uart.h]
2026-05-09 fix(P1-004): 实现 UART 硬件错误分级处理机制，但仅实现代码逻辑，未通过功能验证 - ORE（溢出错误）：立即触发恢复 - FE/NE（帧/噪声错误）：连续 3 次触发恢复 - PE（校验错误）：连续 5 次触发恢复 - 增加连续错误计数器，避免偶发干扰误恢复 - 与 P0-001 熔断机制协同工作 注：代码注入测试无法模拟真正的硬件故障
    [uart.c, uart.h]
2026-05-10 refactor: 优化任务栈配置并补充项目技术文档体系 代码变更： - 优化任务栈配置以匹配 100ms/帧高压测试数据 - 调整栈水位检查间隔单位为秒（100×100ms → 10×1000ms） 文档变更： - 新增协议说明文档，规范化 CRC-16 字节序说明 - 更新 README 版本号至 v1.5.0，同步任务栈配置数据 - 补充开源规范文件（LICENSE/CHANGELOG/C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
    [system_config.h, system_ctrl.c]
2026-05-12 feat(modbus): 实现 180° 舵机控制闭环 (PA6/TIM3_CH1)
    - 新增 BSP 层舵机驱动 (servo.c/h)，支持双通道 PWM 输出
    - 完成 Modbus 寄存器 0x0004 到 PA6 占空比的回调映射
    - 优化架构解耦：将 Error_Handler 下沉至系统层，消除 BSP 对 Core 的依赖
    - 修复 HAL TIM 模块链接报错问题，屏蔽未使用的高级定时器扩展回调
    测试结论：
    - 示波器观测 PA6 波形，频率稳定 50Hz，写入 0/90/180 度，占空比分别为 2.5%，7.5%，12.5%，符合预期
    - 连接180°sg90舵机信号脚测试，功能正常
    [driver_servo.c, driver_servo.h, error_handler.c, error_handler.h, main.c, modbus.c, servo.c, servo.h]
2026-05-12 feat(servo): 实现 360° 舵机速度控制及中位死区处理
    - 新增 Modbus 寄存器 0x0005 (PA7/TIM3_CH2) 映射至 360° 舵机速度控制
    - 实现中位映射逻辑：127 为停止 (1.5ms)，0~126 反转加速，128~255 正转加速
    - 在 BSP 层增加 BSP_Servo_SetPulseWidth 接口，支持微秒级脉宽精确控制
    - 修复 MONITOR_TASK_STACK_SIZE 配置不满足系统校验要求的问题
    - 记录 PWM 切换瞬间单周期波形抖动现象，确认为定时器硬件重加载特性，非软件缺陷
    - 360° 舵机正反转及停止逻辑验证通过
    - 示波器观测切换毛刺仅持续 1 个周期 (<20ms)，舵机机械惯性可过滤
    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
    [driver_servo.c, driver_servo.h, error_handler.c, main.c, modbus.c, modbus.h, servo.c, servo.h]
2026-05-13 feat: 实现系统心跳寄存器与时间片解耦架构
    - 新增 0x0002 只读寄存器，低 4 位每秒翻转（0x000F ↔ 0x0000）
    - 增加 Modbus_InternalWriteRegister 内部写入接口，解决只读标志冲突
    - 修正心跳翻转算法为纯异或操作，修复原逻辑语义错误
    - 重构 Monitor_Task 调度架构：心跳/喂狗/栈检查时间片独立管理
    - 基础循环周期降至 10ms，消除业务逻辑与任务延时的耦合问题
    测试验证：10 分钟高频混合心跳读取，舵机控制测试通过，/心跳规律跳变，100% 成功率
    [modbus.c, modbus.h, monitor_task.c, system_config.h, system_ctrl.h]
2026-05-17 refactor(config): 消除魔法数字与配置规范化重构
    - Modbus 协议层：新增 22 个帧字段索引宏，替换所有硬编码索引（grep → 0 matches）
    - 配置文件职责分离：UART/舵机/错误处理/监控任务配置移至对应头文件
    - system_config.h 从 80+ 行精简至 40 行，仅保留系统级配置
    - 架构规范：BSP 层不依赖 Driver/App 层，引脚命名规范化（BSP_UART1_TX_PIN）
    - 文档同步更新：协议说明增加宏定义列，问题记录更新 P1-002 状态
    - 验证结果：编译通过，烧录成功，功能测试通过（Modbus Poll 读写正常）
    关联问题：P1-002
    修改文件：7 个（modbus.h/c, uart.h/c, driver_servo.h, e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
    [driver_servo.h, driver_uart.h, error_handler.h, modbus.c, modbus.h, monitor_task.h, system_config.h, system_ctrl.h]
2026-05-17 refactor(config): 业务逻辑参数规范化与配置层重构
    - LED任务参数规范化：提取LED翻转周期至宏定义（osDelay(500) → LED_TASK_TOGGLE_INTERVAL_MS）
    - 系统配置校验优化：8处栈/缓冲区校验阈值硬编码替换为宏定义（48U/96U/128U/256U/100U）
    - 配置头文件重构：system_config.h从80+行精简至24行，仅保留系统级配置
    - 架构优化：校验阈值宏移至system_ctrl.h（与System_ValidateConfig函数同模块，高内聚原则）
    - 引脚命名规范化：BSP_UART_TX_PIN → BSP_UART1_TX_PIN，补充System_Check_Stack_Watermark函数声明
    - 文档同步更新：问题记录更新P1-002状态，补充配置层改造实现细节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
    [system_ctrl.c, system_ctrl.h]
2026-05-17 refactor(driver): 驱动层物理参数规范化与宏定义模块化自治
    - 舵机驱动参数提取：将脉宽范围（500-2500us）、角度映射系数提取至 servo.h
    - 360°舵机业务参数：将速度映射中位点（127）、死区范围提取至 driver_servo.h
    - 系统层内部常量：将日志缓冲区大小（80字节）、错误计数类型数提取为文件级宏
    - 配置文件职责分离：严禁向 system_config.h 塞入非全局配置，确保模块自产自销
    - 修复 error_handler.h 宏定义重复问题，消除编译重定义警告
    - 文档同步：更新日志记录、协议说明，版本号推进至 v1.7.0
    [driver_servo.c, driver_servo.h, error_handler.c, error_handler.h, key.h, modbus.h, servo.c, servo.h]
2026-05-17 style(bsp): 应用 .clang-format 格式化 BSP 驱动层代码
    - 格式化范围：BSP 层 5 个头文件 + 5 个源文件（led/uart/servo/key/exti）
    - 应用规则：K&R 大括号风格、4 空格缩进、连续赋值不对齐
    - 代码变更：纯格式化调整，无业务逻辑修改
    - 验证结果：Keil 编译通过，功能测试正常
2026-05-17 fix(protocol): 修复 Modbus 0x06 写寄存器响应格式错误 - 问题根因：0x06 成功响应使用了错误的宏定义（MODBUS_RESP_DATA_START_IDX=3） - 导致现象：响应帧多出字节计数字段，返回 9 字节而非标准的 8 字节 - 修复方案：改用请求帧索引宏（MODBUS_REQ_REG_ADDR_HIGH_IDX=2）构建响应 - 测试验证：0x06 写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
    [modbus.c]
2026-05-17 style(driver): 应用 .clang-format 格式化 Driver 层代码 - 格式化范围：Driver 层 4 个文件（driver_uart/driver_servo） - 应用规则：K&R 大括号风格、4 空格缩进、连续赋值不对齐 - 代码变更：纯格式化调整，无业务逻辑修改 - 验证结果：Keil 编译通过，功能测试正常
2026-05-17 style(all): 应用 .clang-format 统一全项目代码风格 - 格式化范围：BSP/Driver/Protocol/System/Task 共 5 层 28 个文件 - 应用规则：K&R 大括号风格、4 空格缩进、连续赋值不对齐、指针左对齐 - 配置变更：新增 .clang-format 配置文件，关闭 AlignConsecutiveAssignments - 关联修复：同步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
    [error_handler.c, error_handler.h, main.c, modbus.c, modbus.h, monitor_task.c]
2026-05-17 docs: 全项目注释规范化 + 工程规范文档发布
    变更概述:
    完成全项目 6 层 25 个文件的注释规范化，发布嵌入式 C 代码工程规范文档，消除技术债务。
    变更详情:
    - 注释规范化: BSP/Driver/Protocol/System/Task/Core 层 25 个文件，L1-L4 分级注释
    - 工程规范文档: CODING_STYLE.md (350+ 行)，包含格式化/注释/命名/架构六大章节
    - 文档更新: Readme.md v1.8.0, 问题记录.md V1.8, 协议说明.md V1.8
    - 问题归档: 10 个已验证问题移至已解决问题清单，问题记录保留 9 个未处理问题
    [driver_servo.c, driver_servo.h, driver_uart.c, driver_uart.h, error_handler.c, error_handler.h, led.c, led.h]
2026-05-18 fix: 修复 Monitor 任务停止标志与阻塞延时安全隐患
    - P0-003: 添加 volatile 停止标志位，修复 Monitor_Task 退出逻辑
    - P2-007/P2-010: 替换 HAL_Delay() 为 osDelay()，避免看门狗超时
    - P2-009: 增强配置校验，新增栈大小/优先级/看门狗参数合法性检查
    - P2-011: 修正测试指令 CRC16 校验位错误
    [modbus.c, system_ctrl.c, uart.c]
2026-05-18 docs: 完善项目文档体系与硬件接线图
    - 更新 README：新增舵机 PWM 与 I2C 传感器接线示意图
    - 修正测试指令 CRC16 校验位错误
    - 新增 CONTRIBUTING.md 贡献指南与 LICENSE（MIT）
    - 更新 CHANGELOG.md 与日志记录.md
    - 替换硬件实物图为 PNG 格式
2026-05-19 fix(system): 修正任务创建错误码枚举并精简看门狗初始化日志
    - 修正 SYSTEM_ERR_TASK_CREATE_FAILED 为具体的 LED/UART/MONITOR 错误码
    - 删除看门狗初始化成功日志（正常流程无需输出）
    - 保留看门狗初始化失败日志（严重错误必须记录）
    [monitor_task.c, system_config.h, system_ctrl.c, system_ctrl.h]
2026-05-19 refactor(system): 分离错误日志与监控日志的独立控制开关
    - 新增 System_Error_Log() 函数，始终输出关键错误信息
    - 修改 System_Monitor_Log() 仅受 SYSTEM_STACK_WATERMARK_LOG_ENABLE 控制
    - 配置校验失败、任务创建失败、复位检测等改用 System_Error_Log()
    - 栈水位监控日志继续使用 System_Monitor_Log()，生产环境可关闭
    - 更新 system_config.h 注释说明两个宏的职责分工
2026-05-20 fix(modbus): 写入非法值返回异常码而非原样回显
    - 在Modbus_WriteHoldingRegister()中添加舵机参数前置校验
    - 角度>180或速度>255时返回false，触发0x03异常帧
    - 简化回调函数，移除冗余范围检查
    [modbus.c]
2026-05-20 feat(servo): 增加360°舵机死区停止范围0x76-0x88，提升长时间稳定性
    - 增加360°舵机死区范围±10档(0x76-0x88)
    - 解决长时间运转后PWM临界值导致的机械卡顿问题
    - 更新文档中的死区边界值和测试指令
    - 将README文档拆分简化，新增测试指南等三个新文档
    [driver_servo.c, driver_servo.h, modbus.c, monitor_task.h, system_config.h, system_ctrl.c, system_ctrl.h]
2026-05-20 docs: 文档分层重构 - 明确用户手册与开发文档职责边界 - 寄存器映射表.md：定位为用户手册，面向主机开发者与测试人员。 - 协议说明.md：定位为开发文档，面向二次开发与协议扩展者。 - 修复文档错误描述，完善文档信息，增加接线图与实物图 - 去除CHANGELOG.md更新日志 - 修复传感器预设寄存器未设置只读
    [modbus.c, system_ctrl.c]
2026-05-20 docs：修复实物展示图代码错误，无法显示
2026-05-20 docs: 统一360°舵机死区范围表述，消除文档矛盾和错误描述 - 寄存器映射表：统一死区范围，标注边界值有效 - 测试指南：明确边界值不属于死区 - 硬件接线指南：删除I2C上拉矛盾描述 - 协议说明：明确0x06仅舵机寄存器有校验
2026-05-27 chore: 备份 CubeMX 修改前的状态（I2C 传感器接入前）
2026-05-27 feat(i2c): 实现 I2C1 硬件抽象层驱动
    - 新增 Bsp/Inc/i2c.h，定义 I2C1 硬件配置宏（PB6/PB7/100kHz）
    - 新增 Bsp/Src/i2c.c，实现 BSP 层 I2C 操作接口
    - 支持 Master_Transmit/Receive/Mem_Read/Write 四种操作
    - 同步阻塞模式，超时 100ms，返回 bool 状态
    - 中断优先级 5，与 UART 保持一致
2026-05-27 feat(aht20): 完成 AHT20 温湿度传感器 BSP 层驱动
    基于数据手册 V1.3（2024）正确实现：
    - 修正命令发送方式：使用 Master_Transmit（命令式设备）
    - 删除错误的 0xE1 初始化命令（数据手册无此命令）
    - 按手册流程：上电延时 5ms → 触发测量（0xAC 0x33 0x00）→ 延时 80ms → 读取 6 字节
    - 实现原始数据解析（20 位湿度 + 20 位温度）
    - 添加合理性校验（温度 -40~85°C，湿度 0~100%RH）
    测试验证（硬件环境：
    ✅ 初始化成功，校准使能位正常
    ✅ 连续读取稳定，模块测量温度与手机天气数据基本吻合
    [aht20.c, aht20.h, main.c, servo.c, servo.h]
2026-05-27 feat (BMP280): 完成 bmp280 气压温度传感器驱动开发 主要功能: 支持 FORCED/NORMAL 双模式切换 (BMP280_MEASUREMENT_MODE 宏) 支持软件调平偏移补偿 (BMP280_PRESSURE_SOFT_OFFSET_HPA) 配置说明: 默认使用 FORCED 模式，每次读取前触发测量 当前软件调平值 65.42 hPa, 将传感器读值从约 1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
2026-05-27 refactor(i2c): 重构软件 I2C 驱动，修复传感器时序问题
    问题：
    - 硬件 I2C 与 BMP280 不兼容，实测 1059hPa vs 气象站 986hPa（误差 7.4%）
    - 软件 I2C 波形地址错误（0x6C/0x7E），大量 NACK
    - 根因：时序偏离数据手册（起始条件保持时间不足）
    修复：
    - 逻辑分析仪校准延时：tLOW=5.2μs，tHIGH=4.8μs，符合 100kHz 标准
    - 协议分离：寄存器式（BMP280）与命令式（AHT20）独立实现
    - ACK/NACK 规范化：多字节读取最后字节发 NACK
    - WaitAck 增加超时退出机制
    - 移除硬件 I2C 驱动（i2c.c/i2c.h）
    验证：
    - 逻辑分析仪波形符合数据手册
    - BMP280: 996hPa / 29.2°C（误差 ≤1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
    [aht20.c, bmp280.c, bmp280.h, main.c, soft_i2c.c, soft_i2c.h]
2026-05-27 refactor(i2c): 软件 I2C 驱动重构与 BSP 层规范化
    - 软件 I2C 时序校准（5μs 基准，100kHz 标准）
    - 返回值统一为 bool，API 语义一致
    - 移除 HAL 依赖，头文件只包含 stdbool/stdint
    - 魔法数字替换为宏定义，增加错误日志
    - 拆分过长函数，提升可读性
    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
2026-05-27 删除错误工程文件 MDK-ARM/MotorGateway.uvprojx
2026-05-28 style(bsp): 规范化 I2C 传感器驱动注释格式
    修改内容：
    - 删除 `aht20.c` / `bmp280.c` / `soft_i2c.c` 中的 L2/L3 分级标记
    - 规范化宏定义分组及行尾注释（对齐、含单位）
    - 补充全局变量访问规则说明
    - `.c` 文件中删除重复的公共 API 文档块
2026-05-29 feat(uart): 分离 USART2 调试日志，USART1 仅用于 Modbus 通信
    - 新增 USART2 调试口（PA2 TX / PA3 RX），所有调试日志迁移至 USART2
    - 重命名 BSP 层函数：
    - BSP_UART_Send → BSP_UART1_ModbusSend（USART1 Modbus 发送）
    - BSP_UART_PrintString → BSP_UART2_DebugPrint（USART2 调试打印）
    - 重命名 Driver 层函数：
    - UART_Driver_Send → UART1_Driver_ModbusSend（带互斥锁）
    - 新增 UART2_Driver_DebugPrint（调试日志加锁）
    - 更新所有调用点（Modbus、错误处理、传感器驱动）
    - 日志开关集中到 system_config.h
    验证：Modbus UART1通信正常，日志等调试信息仅从 USART2 输出
2026-05-29 refactor(i2c): 软件 I2C 引脚从 PB6/PB7 迁移至 PB8/PB9
    I2C 重构：
    - 软件 I2C 引脚从 PB6/PB7 迁移至 PB8/PB9
    - 硬件 I2C1（PB6/PB7）预留，供后续 MPU6500 使用
    文档更新：
    - README：新增 USART 分工说明，更新 Bsp 层描述和计划功能
    - 寄存器映射表：更新传感器数据格式（×10 + 偏移量）和状态位说明
    - 硬件接线指南：更新 I2C 引脚分配表
    - 日志记录：新增 2026-05-29 工作日志
2026-06-06 refactor(bsp): 传感器驱动返回错误码枚举，移除内部日志
    - AHT20/BMP280 返回值从 bool 改为错误码枚举
    - 删除 BSP 层所有 UART2_DebugPrint 调用
    - 日志由上层统一处理，职责分离
2026-06-06 feat(driver)：新增传感器驱动层，修改I2C传感器延时
    变更：
    - 新增 driver_env_sensor 驱动，封装 AHT20/BMP280 初始化与读取
    - BSP 层延时统一从 HAL_Delay 改为 delay_ms（软件延时）
    - 移除 BSP 层调试日志，增加数据合理性校验
    文件：
    - 新增：driver_env_sensor.c / .h
    - 修改：aht20.c, bmp280.c, soft_i2c.c, soft_i2c.h
    测试：初始化/读取均成功，编译无警告
    已知问题：软件延时精度待优化，后续更换硬件定时器
    [aht20.c, bmp280.c, driver_env_sensor.c, driver_env_sensor.h, main.c, soft_i2c.c, soft_i2c.h, system_ctrl.c]
2026-06-06 refactor: 系统初始化调整，增加LED驱动层与任务架构优化 -传感器初始化移至 device_task，优化 main.c 初始化顺序 - 新增 driver_led，支持多模式且线程安全，故障模式不可覆盖 - 删除 led_task/key_task，新增 device_task 统一管理外设 - 调整任务优先级：UART(High) > Device(Normal) > Monito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
2026-06-06 feat(sensor): 完善传感器驱动，增加重试与故障处理
    - driver_env_sensor 增加重试机制(2次)、限流日志(10秒)、连续失败阈值(5次)
    - 重构代码格式，统一 BSP 层缩进风格，删除冗余注释
    - monitor_task 栈告警宏 LED→DEVICE 重命名，更新阈值
2026-06-06 feat(device): 集成传感器读取与Modbus寄存器更新
    - 新增 device_task，每1秒读取温湿度气压数据
    - 数据转换后写入寄存器0x0000(温度)、0x0001(湿度)、0x0002(气压)
    - 根据 GetStatus 返回值更新寄存器0x0003的Bit4(AHT20)/Bit5(BMP280)
    - LED 驱动集成至 device_task，支持心跳模式
    - 更新日志记录
2026-06-06 feat(sensor): 完成传感器数据上报功能并验证通过错误处理
    - 实现 driver_env_sensor 驱动层，支持 AHT20 + BMP280 数据采集
    - 支持重试机制(2次)、连续失败阈值(5次)、总线恢复
    - 新增 BMP280 空值标志识别，拒绝 0x800000 无效数据
    - BMP280_Read 每次读取前触发 Forced 测量
    - device_task 每 1 秒读取传感器并更新寄存器 0x0000-0x0002
    - 更新寄存器 0x0003 Bit4(AHT20状态) Bit5(BMP280状态)
    - 修复断线重连后气压异常问题
    [bmp280.c, bmp280.h, device_task.c, device_task.h, driver_env_sensor.c, driver_env_sensor.h, soft_i2c.c, soft_i2c.h]
2026-06-06 docs: 完善传感器数据上报功能文档
    - 更新 BMP280 驱动模式：NORMAL_MODE → FORCED_MODE（单次测量）
    - 完善传感器数据上报机制说明：数据流转链路、转换规则、故障处理策略
    - 更新寄存器映射表：0x0000-0x0002 改为"已接入"，补充实际值计算公式和读取示例
    - 补充设备状态寄存器心跳示例（修正为 0x3030 ↔ 0x303F）
    - 新增传感器使用注意事项：更新周期、精度、故障恢复、温差保护
    - 更新 Readme：传感器功能状态标记为已完成，补充技术指标
    - 替换 AHT20/BMP280 传感器接线图
    [bmp280.c]
2026-07-10 docs: 新增系统架构图
2026-07-15 chore: 移除内部开发文档，仅供本地参考
